AG-Kollotzek/surf-etds-phantom/hardware/bom.csv

# SURF Test Unit - bill of materials
#
# Parts of the SURF Test Unit | with the evidence for each row in `source`. For the rig parts | manufacturer
# part number | supplier | unit price and quote date are not documented in this repository.
#
# ROW TYPES: rows with source "not documented" are parts that the repository does not describe. The last
# two rows are calibration instruments | not rig parts.
# NOT INCLUDED: the hardwired emergency stop recommended in docs/safety.md (not fitted).
#
# CITATIONS: path:line refers to this tree; 1d19cc7:path:line refers to a file in git history
# (git show 1d19cc7:path). Plain ASCII on purpose | so the file opens cleanly in any spreadsheet.
item | qty | description | manufacturer | part_number | supplier | unit_price_eur | date_quoted | source | notes
1 | 1 | Microcontroller board, axis controller: Arduino Nano running firmware/axis/SURF_nanoAxis_v5 |  |  |  |  |  | firmware/axis/SURF_nanoAxis_v5/SURF_nanoAxis_v5.ino:4; .github/workflows/arduino-build.yml:26 | Not interchangeable with item 2 (hardware/pinout.md).
2 | 1 | Microcontroller board, heating controller: Arduino Nano running firmware/heating/SURF_nanoHeating_v4 |  |  |  |  |  | firmware/README.md:3; sketch name SURF_nanoHeating_v4; .github/workflows/arduino-build.yml:18,26 | Not interchangeable with item 1 (hardware/pinout.md).
3 | 3 | Closed-loop stepper driver, model designation CL57T; one each for H, V, R |  |  |  |  |  | firmware/axis/SURF_nanoAxis_v5/SURF_nanoAxis_v5.ino:4 (model); :29-35 (three PUL/DIR/ENA pin sets) | The designation alone does not identify manufacturer and hardware revision. Microstep and current settings are build data, see hardware/assembly.md.
4 | 3 | Stepper motor, NEMA 23 frame, 200 full steps per revolution; one per axis |  |  |  |  |  | 1d19cc7:README.md:1 (NEMA 23); 1d19cc7:firmware/arduino/src/oldDrives/firsttry_mitebox.ino:62,68 (200 steps/rev) | NEMA 23 and 200 steps/rev come only from a superseded README title and a superseded sketch.
5 | 2 | Endstop switch, normally closed (NC), wired between input pin and GND; homing reference for H and V |  |  |  |  |  | firmware/axis/SURF_nanoAxis_v5/SURF_nanoAxis_v5.ino:30,33,126-128,246,249; NC wiring: 1d19cc7:firmware/arduino/src/oldDrives/firsttry_mitebox.ino:23-24 | Do NOT fit normally open switches: the firmware treats HIGH as triggered (hardware/pinout.md pitfall 1). No switch exists for R or for the negative ends of H and V.
6 | 2 | Screw with 4 mm lead, linear drive for H and V (200 steps/rev x 16 microsteps / 4 mm = 800 steps/mm) |  |  |  |  |  | firmware/axis/SURF_nanoAxis_v5/SURF_nanoAxis_v5.ino:39 (800 steps/mm); 1d19cc7:firmware/arduino/src/oldDrives/firsttry_mitebox.ino:62-65 (decomposition) | The 4 mm lead is recorded only in a superseded sketch.
7 | 2 | Linear slide/guide, horizontal (H) and vertical (V) |  |  |  |  |  | firmware/axis/SURF_nanoAxis_v5/SURF_nanoAxis_v5.ino:22-26; CITATION.cff:14 | Minimum free travel implied by the firmware is derived in hardware/assembly.md.
8 | 1 | Bevel gearbox, nominal ratio 1:2 (two motor revolutions per output revolution), rotation stage R |  |  |  |  |  | 1d19cc7:firmware/arduino/src/oldDrives/firsttry_mitebox.ino:70 (GEAR_RATIO_R = 2.0); 1d19cc7:docs/PoPargumentation&blueprints.txt:44 (bevel gear 1:2); firmware/tools/rotation_calibration/rotation_calibration.ino:9 | The calibrated 16.156 / 16.1599 steps/deg is about 9% below the nominal 17.78 steps/deg implied by 1:2 x 3200 steps/rev; the actual ratio is not recorded (hardware/assembly.md).
9 | 2 | Temperature sensor DS18B20, one per heating pad, one per OneWire bus |  |  |  |  |  | hardware/calibration/heating-pad-calibration.csv:1; firmware/heating/SURF_nanoHeating_v4/SURF_nanoHeating_v4.ino:8-9,19-20,45-48
10 | 2 | Pull-up resistor, one per OneWire bus (required; value not recorded) |  |  |  |  |  | firmware/heating/SURF_nanoHeating_v4/SURF_nanoHeating_v4.ino:19-20; OneWire 2.3.8 OneWire.cpp:164 (pin set to INPUT, no internal pull-up) | May be on a sensor adapter rather than a discrete part.
11 | 2 | Heating pad bringing the phantom surface to a skin-like temperature |  |  |  |  |  | firmware/heating/SURF_nanoHeating_v4/SURF_nanoHeating_v4.ino:21-22,41-42; README.md:7-8 | Pad voltage is not determinable from the repository (docs/safety.md 6.3).
12 | 2 | MOSFET switching stage, one per pad; gate driven HIGH-active from the heating Nano (D5, D6) |  |  |  |  |  | firmware/heating/SURF_nanoHeating_v4/SURF_nanoHeating_v4.ino:21-22,62,150-156; 1d19cc7:firmware/arduino/src/oldDrives/SURF_nanoHeating_v2.1.ino:31 | Pad state during a Nano reset depends on the gate pull-down (hardware/pinout.md pitfall 6).
13 |  | Power supply for the stepper drivers |  |  |  |  |  | not documented | Output voltage is NOT determinable from the repository. Required by items 3-4.
14 |  | Power supply for the heating pads |  |  |  |  |  | not documented | Whether it is shared with item 13 is not recorded.
15 | 2 | USB cable, PC to Arduino Nano |  |  |  |  |  | software/surf_terminal/terminal.py:30-39 (two serial ports) | Label axis/heating: swapped ports cross-command the controllers (docs/safety.md G7).
16 | 1 | Measurement PC (Windows laptop) running software/surf_terminal |  |  |  |  |  | software/surf_terminal/terminal.py:30-33
17 | 1 | Phantom body carried by the axes (the tracked surface) |  |  |  |  |  | blueprints/heating-off/ETD_QA_PoP_SingleCouchRotation.json:6
18 |  | Frame / base structure and the mounting of the axes on it |  |  |  |  |  | not documented | No CAD, drawing or photo exists (hardware/assembly.md).
19 |  | Mechanical parts not itemised: shaft couplings, bearings, brackets, fasteners |  |  |  |  |  | not documented | The existence and type of each is not recorded.
20 |  | Wiring and connectors: motor, encoder, endstop, alarm, sensor and heater cabling |  |  |  |  |  | not documented | No wiring diagram exists (hardware/pinout.md).
21 |  | Unidentified item named VMA42 |  |  |  |  |  | 1d19cc7:README.md:1 | Named alongside the motors and heating pads in the original README title (3x NEMA23, heating pads, VMA42, MATLAB); nothing in the current firmware or software refers to it.
22 | 1 | Reference thermometer Testo 925 (calibration instrument, NOT part of the rig) | Testo |  |  |  |  | hardware/calibration/heating-pad-calibration.csv:1 | Exclude from rig cost.
23 | 1 | Dial gauge with 0.01 mm divisions (calibration instrument, NOT part of the rig) |  |  |  |  |  | docs/calibration/backlash-measurement-raw.txt:5,20 | Exclude from rig cost. The notebook treats readings above 0.4 mm as unreliable because of the gauge's arc motion (line 14).
