AG-Kollotzek/surf-etds-phantom/data/raw/2025-12-pilot/qa_log_20251204_163333.csv

PC_Time | Arduino_Time | Pos_H_Steps | Pos_V_Steps | Pos_R_Steps | Status_Bits
1764862415.1550012 | 50 | 0 | 0 | 0 | 0
1764862415.2052412 | 100 | 0 | 0 | 0 | 0
1764862415.2556071 | 150 | 0 | 0 | 0 | 0
1764862415.3128378 | 200 | 0 | 0 | 0 | 0
1764862415.3561852 | 250 | 0 | 0 | 0 | 0
1764862415.4055529 | 300 | 0 | 0 | 0 | 0
1764862415.4557261 | 350 | 0 | 0 | 0 | 0
1764862415.506109 | 400 | 0 | 0 | 0 | 0
1764862415.556488 | 450 | 0 | 0 | 0 | 0
1764862415.6065652 | 500 | 0 | 0 | 0 | 0
1764862415.657055 | 550 | 0 | 0 | 0 | 0
1764862415.7062368 | 600 | 0 | 0 | 0 | 0
1764862415.756577 | 650 | 0 | 0 | 0 | 0
1764862415.806978 | 700 | 0 | 0 | 0 | 0
1764862415.857182 | 750 | 0 | 0 | 0 | 0
1764862415.907537 | 800 | 0 | 0 | 0 | 0
1764862415.957909 | 850 | 0 | 0 | 0 | 0
1764862416.007106 | 900 | 0 | 0 | 0 | 0
1764862416.057499 | 950 | 0 | 0 | 0 | 0
1764862416.107779 | 1000 | 0 | 0 | 0 | 0
1764862416.158072 | 1050 | 0 | 0 | 0 | 0
1764862416.208451 | 1100 | 0 | 0 | 0 | 0
1764862416.258618 | 1150 | 0 | 0 | 0 | 0
1764862416.307999 | 1200 | 0 | 0 | 0 | 0
1764862416.358399 | 1250 | 0 | 0 | 0 | 0
1764862416.4085739 | 1300 | 0 | 0 | 0 | 0
1764862416.458965 | 1350 | 0 | 0 | 0 | 0
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
