AG-Kollotzek/surf-etds-phantom/data/raw/2025-12-pilot/qa_log_20251204_163953.csv

PC_Time | Arduino_Time | Pos_H_Steps | Pos_V_Steps | Pos_R_Steps | Status_Bits
1764862795.533279 | 50 | 0 | 0 | 0 | 0
1764862795.583404 | 100 | 0 | 0 | 0 | 0
1764862795.633734 | 150 | 0 | 0 | 0 | 0
1764862795.684148 | 200 | 0 | 0 | 0 | 0
1764862795.734377 | 250 | 0 | 0 | 0 | 0
1764862795.7837172 | 300 | 0 | 0 | 0 | 0
1764862795.834058 | 350 | 0 | 0 | 0 | 0
1764862795.8842938 | 400 | 0 | 0 | 0 | 0
1764862795.9346838 | 450 | 0 | 0 | 0 | 0
1764862795.98503 | 500 | 0 | 0 | 0 | 0
1764862796.03526 | 550 | 0 | 0 | 0 | 0
1764862796.0843399 | 600 | 0 | 0 | 0 | 0
1764862796.1348171 | 650 | 0 | 0 | 0 | 0
1764862796.1852102 | 700 | 0 | 0 | 0 | 0
1764862796.235393 | 750 | 0 | 0 | 0 | 0
1764862796.2857752 | 800 | 0 | 0 | 0 | 0
1764862796.336152 | 850 | 0 | 0 | 0 | 0
1764862796.385327 | 900 | 0 | 0 | 0 | 0
1764862796.435714 | 950 | 0 | 0 | 0 | 0
1764862796.486073 | 1000 | 0 | 0 | 0 | 0
1764862796.5362859 | 1050 | 0 | 0 | 0 | 0
1764862796.586563 | 1100 | 0 | 0 | 0 | 0
1764862796.6370602 | 1150 | 0 | 0 | 0 | 0
1764862796.686353 | 1200 | 0 | 0 | 0 | 0
1764862796.7365592 | 1250 | 0 | 0 | 0 | 0
1764862796.7869499 | 1300 | 0 | 0 | 0 | 0
1764862796.837097 | 1350 | 0 | 0 | 0 | 0
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
