AG-Kollotzek/surf-etds-phantom/data/raw/2026-01-pilot/qa_log_20260126_103910.csv

PC_Time | Arduino_Time | Pos_H_Steps | Pos_V_Steps | Pos_R_Steps | Status_Bits
1769420352.098398 | 50 | 0 | 0 | 0 | 0
1769420352.148591 | 100 | 0 | 0 | 0 | 0
1769420352.1987321 | 150 | 0 | 0 | 0 | 0
1769420352.249231 | 200 | 0 | 0 | 0 | 0
1769420352.2994208 | 250 | 0 | 0 | 0 | 0
1769420352.3487868 | 300 | 0 | 0 | 0 | 0
1769420352.399028 | 350 | 0 | 0 | 0 | 0
1769420352.44942 | 400 | 0 | 0 | 0 | 0
1769420352.499624 | 450 | 0 | 0 | 0 | 0
1769420352.550076 | 500 | 0 | 0 | 0 | 0
1769420352.6004639 | 550 | 0 | 0 | 0 | 0
1769420352.6497002 | 600 | 0 | 0 | 0 | 0
1769420352.699908 | 650 | 0 | 0 | 0 | 0
1769420352.750303 | 700 | 0 | 0 | 0 | 0
1769420352.800446 | 750 | 0 | 0 | 0 | 0
1769420352.850977 | 800 | 0 | 0 | 0 | 0
1769420352.9012039 | 850 | 0 | 0 | 0 | 0
1769420352.9505532 | 900 | 0 | 0 | 0 | 0
1769420353.000763 | 950 | 0 | 0 | 0 | 0
1769420353.05114 | 1000 | 0 | 0 | 0 | 0
1769420353.101472 | 1050 | 0 | 0 | 0 | 0
1769420353.151798 | 1100 | 0 | 0 | 0 | 0
1769420353.201965 | 1150 | 0 | 0 | 0 | 0
1769420353.251461 | 1200 | 0 | 0 | 0 | 0
1769420353.3017259 | 1250 | 0 | 0 | 0 | 0
1769420353.3538518 | 1300 | 0 | 0 | 0 | 0
1769420353.402377 | 1350 | 0 | 0 | 0 | 0
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
