AG-Kollotzek/surf-etds-phantom/data/raw/2026-01-pilot/qa_log_20260126_125034.csv

PC_Time | Arduino_Time | Pos_H_Steps | Pos_V_Steps | Pos_R_Steps | Status_Bits
1769428236.963009 | 50 | 0 | 0 | 0 | 0
1769428236.965015 | 100 | 0 | 0 | 0 | 0
1769428236.966434 | 150 | 0 | 0 | 0 | 0
1769428236.967797 | 200 | 0 | 0 | 0 | 0
1769428236.9691489 | 250 | 0 | 0 | 0 | 0
1769428236.970507 | 300 | 0 | 0 | 0 | 0
1769428236.9718752 | 350 | 0 | 0 | 0 | 0
1769428236.973227 | 400 | 0 | 0 | 0 | 0
1769428236.9773178 | 450 | 0 | 0 | 0 | 0
1769428237.027759 | 500 | 0 | 0 | 0 | 0
1769428237.077312 | 550 | 0 | 0 | 0 | 0
1769428237.126689 | 600 | 0 | 0 | 0 | 0
1769428237.17709 | 650 | 0 | 0 | 0 | 0
1769428237.227762 | 700 | 0 | 0 | 0 | 0
1769428237.277729 | 750 | 0 | 0 | 0 | 0
1769428237.328575 | 800 | 0 | 0 | 0 | 0
1769428237.379284 | 850 | 0 | 0 | 0 | 0
1769428237.428045 | 900 | 0 | 0 | 0 | 0
1769428237.47902 | 950 | 0 | 0 | 0 | 0
1769428237.529 | 1000 | 0 | 0 | 0 | 0
1769428237.579198 | 1050 | 0 | 0 | 0 | 0
1769428237.629596 | 1100 | 0 | 0 | 0 | 0
1769428237.6796422 | 1150 | 0 | 0 | 0 | 0
1769428237.728769 | 1200 | 0 | 0 | 0 | 0
1769428237.779099 | 1250 | 0 | 0 | 0 | 0
1769428237.829438 | 1300 | 0 | 0 | 0 | 0
1769428237.879711 | 1350 | 0 | 0 | 0 | 0
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
