AG-Kollotzek/surf-etds-phantom/data/raw/2026-01-pilot/qa_log_20260126_130855.csv

PC_Time | Arduino_Time | Pos_H_Steps | Pos_V_Steps | Pos_R_Steps | Status_Bits
1769429337.881699 | 50 | 0 | 0 | 0 | 0
1769429337.883348 | 100 | 0 | 0 | 0 | 0
1769429337.884783 | 150 | 0 | 0 | 0 | 0
1769429337.8861818 | 200 | 0 | 0 | 0 | 0
1769429337.887585 | 250 | 0 | 0 | 0 | 0
1769429337.8889759 | 300 | 0 | 0 | 0 | 0
1769429337.890359 | 350 | 0 | 0 | 0 | 0
1769429337.891783 | 400 | 0 | 0 | 0 | 0
1769429337.898346 | 450 | 0 | 0 | 0 | 0
1769429337.947863 | 500 | 0 | 0 | 0 | 0
1769429337.9977431 | 550 | 0 | 0 | 0 | 0
1769429338.048554 | 600 | 0 | 0 | 0 | 0
1769429338.098502 | 650 | 0 | 0 | 0 | 0
1769429338.1486661 | 700 | 0 | 0 | 0 | 0
1769429338.198547 | 750 | 0 | 0 | 0 | 0
1769429338.2486231 | 800 | 0 | 0 | 0 | 0
1769429338.299652 | 850 | 0 | 0 | 0 | 0
1769429338.348253 | 900 | 0 | 0 | 0 | 0
1769429338.398271 | 950 | 0 | 0 | 0 | 0
1769429338.449409 | 1000 | 0 | 0 | 0 | 0
1769429338.5003479 | 1050 | 0 | 0 | 0 | 0
1769429338.5497 | 1100 | 0 | 0 | 0 | 0
1769429338.600396 | 1150 | 0 | 0 | 0 | 0
1769429338.649249 | 1200 | 0 | 0 | 0 | 0
1769429338.700326 | 1250 | 0 | 0 | 0 | 0
1769429338.7502668 | 1300 | 0 | 0 | 0 | 0
1769429338.800268 | 1350 | 0 | 0 | 0 | 0
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
