AG-Kollotzek/surf-etds-phantom/data/raw/2026-01-pilot/qa_log_20260126_131437.csv

PC_Time | Arduino_Time | Pos_H_Steps | Pos_V_Steps | Pos_R_Steps | Status_Bits
1769429679.97329 | 50 | 0 | 0 | 0 | 0
1769429679.974988 | 100 | 0 | 0 | 0 | 0
1769429679.976448 | 150 | 0 | 0 | 0 | 0
1769429679.977885 | 200 | 0 | 0 | 0 | 0
1769429679.979297 | 250 | 0 | 0 | 0 | 0
1769429679.9806888 | 300 | 0 | 0 | 0 | 0
1769429679.982071 | 350 | 0 | 0 | 0 | 0
1769429679.9834728 | 400 | 0 | 0 | 0 | 0
1769429679.986184 | 450 | 0 | 0 | 0 | 0
1769429680.037174 | 500 | 0 | 0 | 0 | 0
1769429680.086869 | 550 | 0 | 0 | 0 | 0
1769429680.136945 | 600 | 0 | 0 | 0 | 0
1769429680.1867049 | 650 | 0 | 0 | 0 | 0
1769429680.2366562 | 700 | 0 | 0 | 0 | 0
1769429680.286737 | 750 | 0 | 0 | 0 | 0
1769429680.336807 | 800 | 0 | 0 | 0 | 0
1769429680.3877609 | 850 | 0 | 0 | 0 | 0
1769429680.437589 | 900 | 0 | 0 | 0 | 0
1769429680.487552 | 950 | 0 | 0 | 0 | 0
1769429680.537486 | 1000 | 0 | 0 | 0 | 0
1769429680.588557 | 1050 | 0 | 0 | 0 | 0
1769429680.637905 | 1100 | 0 | 0 | 0 | 0
1769429680.689125 | 1150 | 0 | 0 | 0 | 0
1769429680.7374341 | 1200 | 0 | 0 | 0 | 0
1769429680.788686 | 1250 | 0 | 0 | 0 | 0
1769429680.8387158 | 1300 | 0 | 0 | 0 | 0
1769429680.888493 | 1350 | 0 | 0 | 0 | 0
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
