AG-Kollotzek/surf-etds-phantom/hardware/calibration/heating-pad-calibration.png

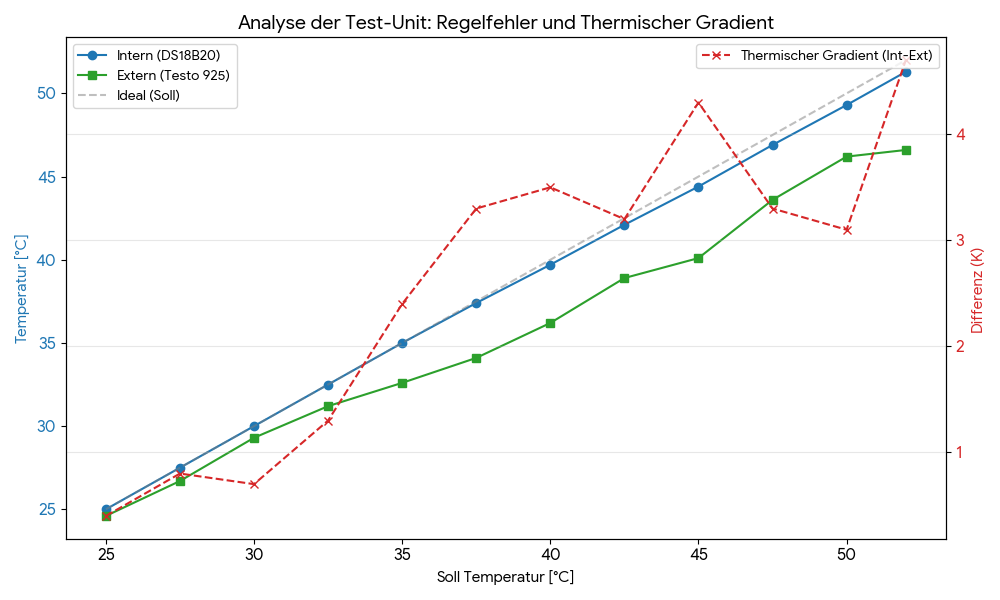
hardware/calibration/heating-pad-calibration.png
