AG-Kollotzek/surf-etds-phantom/(commit log)

2025-12-03 functioning commands via serial homing and moving
2025-12-10 4.12.25 PilotMessung
    [3. messung 0-20-0.csv, dreh +10 messung.csv, letzte mesung ende h 0-10.csv, qa_log_20251204_163333.csv, qa_log_20251204_163953.csv]
2026-01-23 R-Limits und Set up phase (nur angefangen!!)
2026-01-26 control_terminal.py rotationsachse "homing" wegen kabeln
2026-01-26 Add files via upload
    homing works, commands work, threading applied with queue, rotation/vertical calibrated, command done structure applied
2026-01-26 control_terminal.py queuing and threading applied, switch problems
2026-01-28 Add SURF_nanoAxis_v2.5 for temperature control
    noch mit ASCII kommunikation aber funktioniert laut test am 26.01.25
2026-01-28 Add files via upload
    heating treiber mit binär kommunikation
2026-01-28 neues Terminal fusioniert zwei python skripte und kommuniziert mit surf heating nun via binary
    [qa_log_20260126_103910.csv, qa_log_20260126_125034.csv, qa_log_20260126_130855.csv, qa_log_20260126_131437.csv, qa_log_20260126_132735.csv, qa_log_20260126_133044.csv, qa_log_20260126_134212.csv]
2026-02-09 trouble shooting, commands weiterleitung und temperaturen commands und auslesen funktioniert!
2026-02-09 fehler in namen (nanoAxis war aktuelle nano Heating) heating nano geupdated mit pid regelung und nicht blockierend für axis nano
2026-02-10 heating overshoot korrektur
2026-02-10 heating nicht ganz optimal (zu kalt) homing kaputt
2026-02-15 Verwerfen axis treiber (Arbeit an V1.2) Heating treiber robustheit angepasst (v4)
2026-02-15 Big updates für terminal mit simulationsmodus und interpreter. Simulation läuft am pc und lässt testreihe durchgehen.
    axis treiber mit ausgelagerter isTargetSafe funktion
    verkacktes requirements file
2026-02-16 heating v4 anpassungen (heizlücke bei 50°)
2026-02-16 heating v4 anpassungen (heizlücke bei 50°) kalibration (innen vs. außen) einbezogen im terminal.
2026-02-16 heating updater angepasst. muss man sich noch etwas rantasten, aber wird gut.
2026-02-16 interpreter um wait funktion und logging befehl erweitert, basic pop json geschrieben und geadded
2026-02-18 interpreter bug fixed und fucking working! heating weiter gespielt, noch arbeit nötig,
    [ETD_QA_BasicPoP_20260217_165002.csv, ETD_QA_BasicPoP_20260217_170846.csv, ETD_QA_BasicPoP_20260217_172515.csv, ETD_QA_BasicPoP_20260217_173052.csv, ETD_QA_BasicPoP_20260217_173817.csv, firstTry_ETD_QA_BasicPoP_20260217_183645.csv, messung_20260216_175530.csv, messung_20260217_162406.csv]
2026-02-19 Messung im Linac03 3 PoP durchläufe.
    [2.pop1.Hälfte_ETD_QA_BasicPoP_20260219_180023.csv, 3.pop (2xgleich)ETD_QA_BasicPoP_20260219_182108.csv, ETD_QA_1.PoP_20260219_173857.csv, ETD_QA_BasicPoP_20260219_172643.csv]
2026-02-24 universal requirements und single couch rot pop mit syncho move
2026-02-24 trouble shooting und neue bps
2026-02-24 Messung 3 done
    [ETD_QA_PoP_SingleCouchOrientation_20260224_164807.csv, ETD_QA_PoP_SingleCouchOrientation_20260224_170818.csv, ETD_QA_PoP_SingleCouchOrientation_20260224_171955.csv, ETD_QA_PoP_SingleCouchOrientation_20260224_173357.csv, ETD_QA_PoP_SingleCouchOrientation_20260224_173938.csv, ETD_QA_PoP_SingleCouchOrientation_20260224_174533.csv, ETD_QA_PoP_SingleCouchOrientation_20260224_175953.csv, ETD_QA_PoP_Sin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]
2026-03-02 messdaten kw 9
    [ETD_QA_PoP_SingleCouchOrientation_20260224_161639.csv, ETD_QA_PoP_SingleCouchOrientation_20260224_162704.csv]
2026-03-09 ordnung und rename. Aktive Treiber: axis_v5 und heating_v4
    [2.pop1.Hälfte_ETD_QA_BasicPoP_20260219_180023.csv, 3. messung 0-20-0.csv, 3.pop (2xgleich)ETD_QA_BasicPoP_20260219_182108.csv, ETD_QA_1.PoP_20260219_173857.csv, ETD_QA_BasicPoP_20260217_165002.csv, ETD_QA_BasicPoP_20260217_170846.csv, ETD_QA_BasicPoP_20260217_172515.csv, ETD_QA_BasicPoP_20260217_173052.csv]
2026-03-10 axis_v5: backlash implementiert, extra order im paket terminal: backlash befehl, thread crash behoben blueprints: neues für variierte R speeds backlash_measurement.txt dokumentiert die messungen mit 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
    [SURF_nanoAxis_v5.ino]
2026-03-10 Messung 4 done
    [ETD_QA_PoP_SingleCouchOrientation_20260310_152831.csv, ETD_QA_PoP_SingleCouchOrientation_20260310_155154.csv, ETD_QA_PoP_SingleCouchOrientation_20260310_155504.csv, ETD_QA_PoP_SingleCouchOrientation_20260310_160304.csv, ETD_QA_PoP_SingleCouchOrientation_20260310_160448.csv, ETD_QA_PoP_SingleCouchOrientation_20260310_160950.csv, ETD_QA_PoP_SingleCouchOrientation_20260310_161302.csv, ETD_QA_PoP_Sin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]
2026-03-31 csv stuff
    [ETD_QA_PoP_SingleCouchOrientation_20260325_163729.csv, ETD_QA_PoP_SingleCouchOrientation_20260325_164218.csv, ETD_QA_PoP_SingleCouchOrientation_20260325_165711.csv, ETD_QA_PoP_SingleCouchOrientation_20260325_170823.csv, ETD_QA_PoP_SingleCouchOrientation_20260325_171131.csv, ETD_QA_PoP_SingleCouchOrientation_20260325_172135.csv, ETD_QA_PoP_SingleCouchOrientation_20260325_172429.csv, ETD_QA_PoP_Sin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]
2026-04-08 csv stuff poster
    [ETD_ClinTest_20260408_162112.csv, ETD_ClinTest_20260408_162329.csv, ETD_ClinTest_20260408_162542.csv, ETD_ClinTest_20260408_164159.csv, ETD_ClinTest_20260408_164252.csv, ETD_ClinTest_20260408_164444.csv, ETD_ClinTest_20260408_164532.csv, ETD_ClinTest_20260408_165233.csv]
2026-05-12 test qa csv
    [ETsurface_easyQA_20260512_161137_QA.csv]
2026-07-15 csv qa linac 1 push
    [ETD_QA_BasicPoP_20260715_141909.csv, ETD_QA_BasicPoP_20260715_141909_QA.csv, ETD_QA_PoP_SingleCouchOrientation_20260715_142333.csv, ETD_QA_PoP_SingleCouchOrientation_20260715_142333_QA.csv, ETD_QA_PoP_SingleCouchOrientation_20260715_142924.csv, ETD_QA_PoP_SingleCouchOrientation_20260715_142924_QA.csv, ETsurface_easyQA_20260513_144731.csv, ETsurface_easyQA_20260513_144731_QA.csv]
2026-07-29 csv qa linac 0 push
    [ETsurface_easyQA_20260729_162730.csv, ETsurface_easyQA_20260729_162730_QA.csv, ETsurface_easyQA_T32_20260729_164238.csv, ETsurface_easyQA_T32_20260729_164238_QA.csv]
2026-08-06 dokumentations funktion messungen
    [ETsurface_easyQA_20260806_152005.csv, ETsurface_easyQA_20260806_152005_QA.csv]
2026-08-06 documentation and data qa linac 3+4 push
    [ETsurface_easyQA_20260806_163851.csv, ETsurface_easyQA_20260806_163851_QA.csv, ETsurface_easyQA_20260806_165555.csv, ETsurface_easyQA_20260806_165555_QA.csv, ETsurface_easyQA_20260806_173403.csv, ETsurface_easyQA_20260806_173403_QA.csv, ETsurface_easyQA_20260806_180321.csv, ETsurface_easyQA_20260806_180321_QA.csv]
2026-09-15 Restructure and sanitise the repository for publication
    Reorganise the acquisition repository into a layout that can stand on its own
    and sit next to the analysis repository:
    firmware/{axis,heating,tools}/ Arduino sketches (was firmware/arduino/src)
    software/surf_terminal/ measurement terminal as a package
    blueprints/{qa,pop,heating-off}/ measurement sequences
    data/raw/<campaign>/ ground-truth campaigns
    hardware/calibration/, matlab/, docs/calibration/
    Sanitise the data and history-facing content:
    - Replace operator first names in measurement protocols with role codes
    (QMP1, Student1-3), and remove names from the terminal placeholder and the
    backlash la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
    [ETD_ClinTest_20260408_162112.csv, ETD_ClinTest_20260408_162329.csv, ETD_ClinTest_20260408_162542.csv, ETD_ClinTest_20260408_164159.csv, ETD_ClinTest_20260408_164252.csv, ETD_ClinTest_20260408_164444.csv, ETD_ClinTest_20260408_164532.csv, ETD_ClinTest_20260408_165233.csv]
2026-09-15 Add licences, citation and contributor metadata
    The repository is split-licensed, because its parts are different kinds of
    work:
    - MIT for software, blueprints, MATLAB and hardware documentation;
    - GPL-3.0-or-later for firmware/, which links AccelStepper (GPL or
    commercial);
    - CC-BY-4.0 for data/ and docs/.
    Full texts are in LICENSES/, with per-directory copies in firmware/ and data/.
    CITATION.cff references the companion analysis repository and explains why
    the licence field names only the software default. CONTRIBUTORS.md records
    the three people in the history and the open consent question that must be
    settled before the repository is made public.
    Pin dependencies: supported ranges in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
2026-09-15 Document hardware, protocols, data and known issues
    Rewrite the README, which described files that did not exist and omitted the
    measurement terminal. It now puts the not-a-medical-device statement, the
    missing hardware E-stop and the silent failure modes above the fold.
    Add reference documentation, each claim cited to file and line:
    - docs/serial-protocol.md: the PC <-> Arduino wire protocol, including its
    framing weaknesses.
    - docs/blueprint-format.md and blueprints/schema/blueprint.schema.json: the
    measurement-sequence DSL; all 29 blueprints validate.
    - docs/data-dictionary.md and data/README.md: the four file families, measured
    sample rates, format drift and caveats for reuse.
    - d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
    [bom.csv, runs.csv]
2026-09-15 Document the reference geometry and kV cross-validation sensitivity
    Record two properties of the phantom found in the 10 March 2026 campaign:
    - Geometry the kinematic model does not contain. Direction-reversing residual
    components that the model predicts to be zero repeat across runs and at
    both temperatures. Three parameters account for all five: a ~2.1° yaw of the
    vertical axis's tilt axis (two independent ratios and kV imaging agree), a
    ~0.6-0.7° apparent yaw of horizontal travel, and a ~1.3 mm offset of the
    tracked centroid from the rotation axis.
    - Sensitivity of kV cross-validation to the calibrated lever arm, by imaging
    position: one 0.1 mm readout step corresponds to ~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
2026-09-15 Record contributor consent and remove open-task markers
    All contributors agreed to the release, so CONTRIBUTORS.md records that
    instead of an open consent item, and CITATION.cff loses its reminder
    comments.
    The published documentation describes completed work. Remove every TODO
    marker, checklist and instruction for future work from the hardware
    documentation and the code of conduct; keep all established facts and
    citations, and state plainly where something is not documented. The bill of
    materials keeps its 23 rows and 10 columns.
    [bom.csv]
2026-09-15 Use the public repository names
    The repository is published as surf-etds-phantom and the analysis repository
    as surf-etds-analysis. Point the citation metadata, package metadata, schema
    id, data licence and documentation at those names, and drop a commit hash of
    the analysis repository that its published copy will not contain.
    [runs.csv]
2026-09-16 Make the first CI run pass and correct drifted line citations
    Remove two unused imports and two unused exception bindings in the terminal without moving any line, leave one-line if bodies to style (E701), and pin ruff. Keep arduino-build.yml line numbers stable for the documents that cite them, and update seven citations into README.md, CHANGELOG.md and CITATION.cff that pointed at neighbouring lines.
    [bom.csv]
2026-09-16 Quote the Arduino library versions
    compile-sketches parses the library list as YAML, which read AccelStepper 1.64 as a number and failed. Quote every version so all are read as strings.
2026-09-16 Point commit references at the published history
    Publishing rewrote the history, which changes every commit hash. Update the hashes cited in the documentation to their rewritten commits.
    [bom.csv]
